Emery85/soil-moisture-sensor/docs/specs/ESP32_Solar_Sensor_TechSpec_v1.1.docx

TECHNICAL SPECIFICATION

ESP32 Solar-Powered Soil Moisture Sensor Node

Document Version 1.1 — 15 May 2026

Document Status | Released — For Build
Project Type | Personal Hobby / Non-commercial
Microcontroller | ESP32 (existing)
Firmware Framework | Arduino + PlatformIO
Data Destination | Discord webhook via HTTP POST
Author | Project Owner
Related Docs | Project Charter v0.1, BOM v1.0, Decision Log

Personal Project Documentation • Not for Distribution

# 1. Purpose and Scope

This Technical Specification defines the hardware wiring, component integration, development environment, firmware architecture, and calibration procedure for the ESP32 Solar-Powered Soil Moisture Sensor Node. It serves as the primary reference for physical assembly and software development, bridging the Bill of Materials (BOM v1.0) and the Wiring / Assembly Guide (D-6).

All design decisions referenced herein are recorded in the Decision Log. Open items OI-1 through OI-5 are closed; no blocking items remain.

# 2. System Overview

The sensor node consists of five functional subsystems:

Subsystem | Function | Key Components
Power | Solar harvest, battery charge management, regulated 3.3V supply | 6V 3W panel, TP4056 w/ protection, 18650 cell, LDO or MT3608
Sensing | Capacitive soil moisture measurement via ADC | Capacitive v1.2 module, ESP32 GPIO34 (ADC1_CH6)
Processing | Sample, sleep, wake, publish | ESP32-WROOM-32 or equivalent
Communication | Wi-Fi HTTP POST to Discord webhook on threshold breach | ESP32 Wi-Fi, HTTPClient library, ArduinoJson library
Enclosure | Weatherproof outdoor housing | IP65 junction box or PETG/ASA 3D print

The node operates on a 12-hour deep-sleep / wake / sample / publish cycle. Power consumption at this interval is effectively negligible relative to the solar harvest capacity confirmed in the power budget analysis.

# 3. Component Specifications

## 3.1 Microcontroller — ESP32

Parameter | Value
Module | ESP32-WROOM-32 (30-pin DevKit or equivalent breakout)
Core | Xtensa dual-core LX6, 240 MHz
Flash | 4 MB minimum
Wi-Fi | 802.11 b/g/n 2.4 GHz
Supply voltage | 3.3V regulated (DO NOT supply 5V to 3V3 pin)
Deep sleep current | ~10 µA (RTC timer wake only, peripherals off)
Active/Tx peak | ~240 mA (short burst during Wi-Fi transmit / HTTP POST)
ADC pins used | GPIO34 (ADC1_CH6) — input only, 3.3V max

WARNING: Never power the ESP32 3V3 pin from a 5V source. Use the VIN/USB pin only if the onboard LDO is present. When powering from the 18650 directly, route through a 3.3V LDO (e.g. AMS1117-3.3) or the TP4056 output rail if regulated.

## 3.2 Soil Moisture Sensor — Capacitive v1.2

Parameter | Value
Type | Capacitive (not resistive — no electrolysis corrosion)
Supply voltage | 3.3V – 5V (power from ESP32 3V3 or switched GPIO for power gating)
Output | Analog voltage, 0–3.0V typical range
Dry reading (air) | ~2900–3200 ADC counts (12-bit, 0–4095)
Wet reading (saturated) | ~1200–1500 ADC counts
Current draw | ~5 mA when active
Interface | Single analog wire to GPIO34
Conformal coat | REQUIRED on PCB traces before deployment (nail polish or acrylic spray acceptable)

NOTE: Calibrate wet and dry ADC counts on your specific unit before setting alert thresholds. Values vary between clone batches. See Section 8 (Calibration Procedure).

## 3.3 Charging Circuit — TP4056 with Protection Board

Parameter | Value
IC | TP4056 CC/CV Li-Ion charger + DW01A protection + FS8205 MOSFET
Module variant required | Two-chip module WITH protection board (NOT bare TP4056 alone)
Input voltage | 4.5V – 6V (verify your kit board includes a Schottky diode on the solar input — most do; see Section 3.3 notes)
Charge current | 1A default (R_prog = 1.2 kΩ) — adequate for 3400 mAh cell
Charge termination | CC/CV, terminates at 4.2V
Protection features | Over-charge, over-discharge (cutoff ~2.4V), over-current, short
Output (B+ / B-) | Direct cell voltage (3.6V–4.2V) — regulate before feeding ESP32
Standby current | <1 mA

NOTE: Most TP4056 kit/breakout boards sold for solar use already include a Schottky diode (or equivalent MOSFET-based reverse-blocking circuit) on the solar input. Inspect your board before adding an external diode — duplicating it wastes voltage and heat. If the board schematic or silkscreen shows a diode symbol on the IN+ trace, you are covered. If it only has a micro-USB/USB-C input and bare pads for solar, add a 1N5819 externally.

## 3.4 Power Regulation

Options for converting 18650 output (3.6V–4.2V) to 3.3V:

Option | Pros | Cons | Recommended
AMS1117-3.3 LDO | Simple, cheap (~$0.10) | Linear dropout; wastes voltage headroom near 3.6V | Acceptable for this load
HT7333 LDO | Lower dropout (100mV), low quiescent current (~4 µA) | Slightly more expensive | Preferred if available
ESP32 DevKit onboard LDO | Already present on most DevKits (AMS1117) | Powers via VIN/USB 5V input — needs MT3608 boost upstream | Use if boosting 18650 to 5V

NOTE: If powering the ESP32 DevKit via its USB/VIN pin, you need a MT3608 boost converter (18650 3.6–4.2V → 5V). If powering from 3V3 pin directly, use HT7333 or AMS1117-3.3.

## 3.5 Solar Panel

Parameter | Value
Rated power | 3W (6V, 500mA Isc)
Dimensions (typical) | 145 × 145 mm (varies by supplier)
Voc (open circuit) | ~7.2V — within TP4056 input range; Schottky drop reduces this ~0.3–0.5V
Connection | Connect to solar input pads on TP4056 board; verify board includes reverse-blocking diode (see Section 3.3 notes)

## 3.6 Battery

Parameter | Value
Cell type | 18650 Li-Ion
Capacity | 3400 mAh (Samsung 35E or equivalent)
Nominal voltage | 3.6V
Max charge voltage | 4.2V
Min discharge voltage | 3.0V (TP4056 protection cuts at ~2.4V)
Autonomy (no sun) | >2000 days at 12-hour sample interval (theoretical)

# 4. Pin Mapping and Wiring Assignments

## 4.1 ESP32 GPIO Assignments

GPIO | Function | Connected To | Direction | Notes
GPIO34 | Moisture ADC input | Sensor AOUT pin | Input | Input-only GPIO; 3.3V max; no internal pull-up
GPIO4 (optional) | Sensor power gate | Sensor VCC via MOSFET | Output | Pull HIGH to power sensor; pull LOW to cut power between readings (optional optimization)
3V3 | Sensor VCC (direct) | Sensor VCC if not gating | Power out | Max 200mA combined from 3V3 rail
GND | Common ground | Sensor GND, TP4056 GND, panel GND | Power | All grounds must be common
EN / RST | Wake from deep sleep | Not used (timer wake only) | Input | RTC timer handles wake; EN pulled high internally
VIN or USB | ESP32 power in (if using onboard LDO) | MT3608 5V output or USB power bank | Power in | Only if using DevKit onboard LDO path

## 4.2 Wiring Topology Diagram (Text)

The following describes the signal and power flow from panel to data:

Solar Panel (+) ──> TP4056 Solar IN+ (board includes reverse-blocking diode)

Solar Panel (-) ──────────────────────> TP4056 IN-

TP4056 B+ ──> 18650 (+) / TP4056 B- ──> 18650 (-)

TP4056 OUT+ ──> [HT7333 or AMS1117-3.3] IN ──> ESP32 3V3

OR

TP4056 OUT+ ──> [MT3608 Boost] IN ──> ESP32 VIN (5V)

ESP32 3V3 ──> Sensor VCC

ESP32 GND ──> Sensor GND

Sensor AOUT ──> ESP32 GPIO34

ESP32 Wi-Fi ~~(wireless)~~> Discord Webhook (HTTP POST on threshold breach)

NOTE: Draw or photograph your actual wiring before first power-on and retain it in the project file. Discrepancies between this spec and your build should be documented in the Decision Log.

## 4.3 Decoupling Capacitor — DevKit Considerations

ESP32 DevKit boards include onboard decoupling capacitors near the LDO regulator, which handle the majority of Wi-Fi transmit spikes under normal USB-powered conditions. For this project, power arrives via the TP4056 output through an LDO — a slightly less regulated path than USB.

In practice, brownout resets are uncommon on DevKits with a properly spec'd LDO and short wiring. The best first approach is to build without an external capacitor, run test T-05 (the deep-sleep/wake/publish cycle test in Section 10), and monitor Serial output for brownout reset messages. If resets occur, add a 470 µF electrolytic capacitor across the 3V3 and GND pins as close to the ESP32 module as possible — this is the proven fix. Keep the leads short; the capacitor is ineffective if mounted far from the chip.

# 5. Development Environment

## 5.1 Toolchain

Tool | Version | Purpose | Install / Source
PlatformIO IDE | Latest | Project management, build, flash, serial monitor | VS Code extension: platformio.platformio-ide
Arduino Framework (ESP32) | Arduino-esp32 ≥ 2.0 | HAL and Arduino API for ESP32 | Managed by PlatformIO automatically
HTTPClient | Built-in (Arduino-esp32) | HTTP POST to Discord webhook | Included with Arduino-esp32 framework — no separate install needed
ArduinoJson | ≥ 6.x | Build JSON payload for Discord message | PlatformIO library: bblanchon/ArduinoJson
Git | Any | Version control for firmware source | git-scm.com or OS package manager

## 5.2 PlatformIO Project Structure

my-soil-sensor/

platformio.ini ; board config, dependencies

src/

main.cpp ; application entry point

include/

config.h ; Wi-Fi creds, Discord webhook URL, thresholds (gitignored)

data/ ; SPIFFS/LittleFS assets if used

.gitignore ; exclude config.h, .pio/

## 5.3 platformio.ini (Baseline)

[env:esp32dev]

platform = espressif32

board = esp32dev

framework = arduino

monitor_speed = 115200

lib_deps =

bblanchon/ArduinoJson @ ^6

## 5.4 config.h (Template — gitignore this file)

#pragma once

// Wi-Fi

const char* WIFI_SSID = "your_ssid";

const char* WIFI_PASSWORD = "your_password";

// Discord

const char* DISCORD_WEBHOOK = "https://discord.com/api/webhooks/YOUR_ID/YOUR_TOKEN";

// Thresholds (ADC counts, 0-4095)

const int DRY_THRESHOLD = 2400; // calibrate per Section 8

WARNING: Never commit config.h to a public repository. It contains Wi-Fi credentials. Add it to .gitignore before the first commit.

# 6. Firmware Architecture

## 6.1 Execution Flow

The firmware follows a linear boot-to-sleep pattern. There is no persistent event loop. Each wake cycle is a complete, independent execution:

Step | Action | Key API / Notes
1 | Power on / wake from deep sleep | ESP.restart reason: ESP_SLEEP_WAKEUP_TIMER
2 | Configure ADC (12-bit, GPIO34) | analogSetAttenuation(ADC_11db) for 0–3.3V range
3 | Read sensor (optional: average 5 samples) | analogRead(34)
4 | Convert ADC to moisture percentage | Map dry_count→0%, wet_count→100%
5 | Connect to Wi-Fi (with timeout) | WiFi.begin() — timeout after 10s; log failure and sleep
6 | Build Discord JSON payload | ArduinoJson: {"content": "Soil moisture low: 28%"}
7 | HTTP POST to Discord webhook (conditional on threshold breach) | HTTPClient: POST to DISCORD_WEBHOOK URL; check HTTP 204 response
8 | Disconnect Wi-Fi | WiFi.disconnect(true); WiFi.mode(WIFI_OFF)
9 | Enter deep sleep (12 hours) | esp_sleep_enable_timer_wakeup(12ULL * 3600 * 1000000)
10 | esp_deep_sleep_start() | All peripherals off; RTC timer fires after 12h

## 6.2 Discord Notification Strategy

The device connects to Wi-Fi on every wake cycle (to keep the connection logic simple and avoid state management across deep sleep). However, it only POSTs to the Discord webhook when the moisture reading crosses below the alert threshold — not on every reading. This avoids notification spam at 2 readings/day.

Discord webhook POST format (JSON body):

POST https://discord.com/api/webhooks/YOUR_ID/YOUR_TOKEN

Content-Type: application/json

{ "content": "⚠️ Garden soil moisture is LOW: 28%\nRaw ADC: 2541\nCheck and water if needed." }

The webhook URL is obtained from Discord server settings: Server Settings > Integrations > Webhooks > New Webhook. The URL is sensitive — treat it like a password and do not commit it to a public repo (it is in the gitignored config.h).

Optional: use a Discord embed for richer formatting by posting a full embed object instead of a plain content string. Not required for v1.

NOTE: Discord webhooks return HTTP 204 No Content on success. Check for this in the HTTPClient response code to confirm delivery.

## 6.3 Deep Sleep Duration

The configured interval is 12 hours. To change the interval, modify the constant in main.cpp:

#define SLEEP_INTERVAL_US (12ULL * 3600ULL * 1000000ULL) // 12 hours

// For testing: use 30ULL * 1000000ULL (30 seconds) during bench validation

## 6.4 Error Handling

Condition | Behavior
Wi-Fi connect timeout (>10s) | Log error to Serial; skip HTTP POST; proceed to deep sleep
Discord webhook HTTP error (non-204) | Log response code to Serial; skip retry in v1; proceed to deep sleep
ADC read out of range | Clamp value to 0–100%; flag in payload: "status": "adc_warn"
Low battery (optional) | If voltage divider fitted on A0: publish battery_mv; no shutdown logic in v1

# 7. Discord Webhook Integration

## 7.1 Setting Up the Webhook

- Open the Discord server where notifications will be received
- Go to Server Settings > Integrations > Webhooks > New Webhook
- Name it (e.g. "Garden Sensor"), assign it to a dedicated channel (e.g. #garden-alerts)
- Click Copy Webhook URL — this is the URL that goes into config.h as DISCORD_WEBHOOK
- Test the webhook manually: use curl or a tool like Postman to POST a test message before flashing firmware

curl -X POST -H "Content-Type: application/json" \

-d '{"content": "Test from soil sensor"}' \

https://discord.com/api/webhooks/YOUR_ID/YOUR_TOKEN

Expected response: HTTP 204 No Content (empty body). Any 4xx response indicates an invalid or deleted webhook URL.

## 7.2 Mobile Notifications

Discord mobile app delivers push notifications for messages in channels you follow. To ensure alerts reach your phone:

- Enable notifications for the #garden-alerts channel in the Discord mobile app
- In channel settings, set notification override to "All Messages" so every webhook post triggers a push
- Discord push notifications typically arrive within a few seconds of the POST

## 7.3 Alert Logic

The firmware only POSTs when moisture falls below DRY_THRESHOLD. To avoid repeated alerts every 12 hours while the soil remains dry, consider one of these approaches in v1 firmware:

- Simple: alert on every reading below threshold (acceptable at 2 readings/day — low spam risk)
- Better: store a "last alert sent" flag in RTC memory (survives deep sleep); only alert once per dry event until moisture recovers above threshold

NOTE: RTC memory (rtc_data_attr variables) persists across deep sleep but is lost on full power cycle. Adequate for this use case.

# 8. Calibration Procedure

The capacitive v1.2 sensor output varies between individual units. Calibration must be performed before setting thresholds in config.h.

Step | Action | Record As
1 | Connect sensor to ESP32; load test sketch that prints analogRead(34) to Serial every 2 seconds | —
2 | Hold sensor in open air (completely dry) for 60 seconds; note stable ADC count | DRY_COUNT
3 | Submerge sensor electrode in water up to the max-fill line (do not submerge PCB); note stable ADC count | WET_COUNT
4 | Update DRY_THRESHOLD in config.h and the map() call: map(raw, WET_COUNT, DRY_COUNT, 100, 0) | —
5 | Verify: sensor in dry soil should read 0–20%; sensor in well-watered soil should read 60–100% | —
6 | Record calibration values in Decision Log | DRY_COUNT, WET_COUNT, date, unit ID

NOTE: ADC counts decrease as moisture increases (wetter soil = lower voltage output). The map() call reverses the range so that 100% = wettest.

# 9. Enclosure and Deployment

## 9.1 Enclosure Requirements

Requirement | Detail
IP rating | IP65 minimum (dust-tight, water jet resistant)
Material | IP65 junction box (ABS/polycarbonate) or PETG/ASA 3D print
Panel mount | Solar panel exterior; cable gland for wiring entry
Cable glands | IP68-rated; tighten after routing all wires; orient downward
Sensor probe routing | Probe exits through cable gland into soil; PCB remains inside enclosure
Conformal coat | Apply to sensor PCB traces before sealing; allow 24h cure time

## 9.2 Solar Panel Placement

- Mount panel at an angle (15–45°) facing south (northern hemisphere) for maximum daily exposure
- Avoid shade from trees, structures, or the enclosure itself in morning/afternoon hours
- Verify Wi-Fi signal strength at the planned install location before final mounting

# 10. Pre-Deployment Test Plan

The following tests must pass before outdoor deployment. Record results and any deviations in the Decision Log.

Test ID | Test Description | Pass Criteria
T-01 | Bench power — ESP32 on regulated 3.3V bench supply | Boots without brownout; Serial output visible
T-02 | Sensor ADC read — dry and wet calibration | DRY_COUNT and WET_COUNT recorded; values stable ±50 counts
T-03 | Wi-Fi connect | Connects to SSID within 10 seconds
T-04 | Discord webhook POST | HTTP 204 received; message appears in Discord channel on phone
T-05 | Deep sleep / wake cycle (30s interval) | Device wakes, reads, publishes, and sleeps repeatably for 10 cycles
T-06 | Full system — battery + TP4056 + LDO | System powers from 18650; no resets; Vout 3.3V ±0.1V
T-07 | Solar charging | TP4056 CHRG LED on in sunlight; STBY LED when full
T-08 | Enclosure seal test | Simulate rain (garden hose, 1 minute); no moisture inside
T-09 | 48-hour soak test | Device publishes correct readings every 12h for 4 cycles without intervention
T-10 | Discord alert trigger | Insert sensor in dry medium; Discord notification appears on phone within one publish cycle

# 11. Known Risks and Mitigations

Risk | Likelihood | Impact | Mitigation
Sensor corrosion in wet soil | Medium | Medium | Conformal coat before deployment; inspect quarterly; budget for replacement
Wi-Fi signal loss at garden location | Medium | High | Test signal at install location (T-03); consider ESP32 with external antenna if marginal
Brownout during Wi-Fi Tx | Low | Medium | DevKit has onboard decoupling; build without external cap first; add 470 µF at 3V3/GND if T-05 shows reset events (see Section 4.3)
Enclosure water ingress | Low | High | IP65 box; cable glands torqued; T-08 seal test required before deployment
TP4056 without protection board | Low | Critical | Verify two-chip module on arrival; mark protection chip with paint pen
ADC nonlinearity near 3.3V rail | Low | Low | Average 5 samples; discard outliers; stay in 0.1V–3.1V sensor output range

# 12. Document Control

Version | Date | Author | Changes
1.0 | 2026-05-13 | Project Owner | Initial release. All OIs closed. Ready for assembly.
1.1 | 2026-05-15 | Project Owner | Data destination updated: MQTT/Home Assistant replaced with Discord webhook (DL-07). Schottky diode guidance revised to reflect kit board inclusion. Decoupling capacitor guidance revised to test-first approach for DevKit. Section 7 rewritten for Discord integration.

Related documents: Project Charter v0.1 | BOM v1.0 | Decision Log | Wiring / Assembly Guide (D-6, pending)

— End of Document —

ESP32 Solar Soil Sensor — Technical Specification Page

TECHNICAL SPECIFICATION v1.1 | 2026-05-15
