Emery85/soil-moisture-sensor/docs/bom/BOM_Procurement.xlsx

Sheet: BOM
BILL OF MATERIALS (BOM) — PROCUREMENT TEMPLATE
Project: |  |  | [Project Name] |  | Revision: |  | A |  | Date: |  |  |  | Prepared By:
Item # | Vendor | Part Number | Manufacturer | Manufacturer Part # | Description | Revision | Category | UOM | Qty Per Assembly | Total Qty Required | Unit Cost (USD) | Extended Cost (USD) | Lead Time (Days) | Notes / Supplier
1 | Amazon | B08N1DD5WJ | Otdorpatio | 788405512983 | Electrical Junction Box Power Enclosure (7.87” x 4.72” x 2.95”) | A | Enclosures / Hardware |  | 1.00 | 1.00 | $9.99 | $9.99 | 2
2 | Amazon | B0FH6LH8WQ | Tnyvm | TYA250 | 2 IP68 Breather Screw Air Vent, M12x1.5 Presure Reducing valve, lighting breather plug for moisture and pressure control venting screw for outdoor electrical enclosures | A | Enclosures / Hardware |  | 1.00 | 1.00 | $2.94 | $2.94 | 2
3 | Amazon | B0FL22G77N | Meccanixity | mea25061ee000420 | 6V 3W 500mA mini solar panels, Small polycrystalline solar cell panel with 2 cable for DIY electric toy materials kits charger, 145mm x 145mm | A | Power & Energy |  | 1.00 | 1.00 | $13.29 | $13.29 | 20
4 | Amazon | B0FH22F8SB | 1DFAUL | 612715112000 | 100ml Conformal Coating for Electronics, Silicone Comformal coating insulating sealant, waterproof, dust & moisture resistant, for reliable electronic components protection | A | Coatings & Protection |  | 1.00 | 1.00 | $12.89 | $12.89 | 2
5 | Amazon | B082F7X8WS | HiLetgo | HiLetgo | 2pc CN3065 Mni Solar lipo Charger Board Lithium Battery charge chip micro usb diy outdoor application kit charging board module | A | Power & Energy | Set | 1.00 | 1.00 | $6.49 | $6.49 | 2
6 | Amazon | B0BJV7SK5D | DIANN | 687117701701 | 10pcs 18650 Battery Holder single 1x 3.7V 18650 Battery Holder 18650 Battery Holder with Wires | A | Power & Energy | Set | 1.00 | 1.00 | $5.99 | $5.99 | 2
7 | Amazon | B0CY8HM7HR | Vbeijll | US-VB-GZJ01 | Silica Gel Packets, Rechargeable Moisture absorbers for food storage, electronics, 3d filament & safes | A | Enclosures / Hardware | Set | 1.00 | 1.00 | $9.95 | $9.95 | 2
8 | Amazon | B01MSZW5HQ | uxcell | a16101800ux0286 | 10pcs M12 waterproof IP68 Nylon Cable Gland Joint adjustable locknut for 3mm-6.5mm dia Cable wire | A | Enclosures / Hardware | Set | 1.00 | 1.00 | $5.79 | $5.79 | 2
9 | Amazon | B094J8XD83 | AITRIP | AITRIP | 10 pack Capacitive Soil Moisture sensor corrosion resistant for arduino moisture detection garden watering DIY electronic for arduinio and raspberry pi | A | Sensors | Set | 1.00 | 1.00 | $11.99 | $11.99 | 2
10 | Amazon | B0F297R23T | Ladinka | cg001 | 580 pcs M3 Black Nylon standoff kit with spacers, screws and nuts – motherboard PCB mounting standoffs and screws, threaded pillar spacers for circuit boards and computer building | A | PCB & Assembly | Set | 1.00 | 1.00 | $0.24 | $0.24 | 2
11 | Amazon | B08D5ZD528 | AITRIP | 15363 | Esp-wroom-32 esp 32 esp-32s development board 2.4ghz dual-mode wifi + bluetooth dual cores microntroller processor integrated with antenna rf amp filter ap sta compatible with arduino ide (3 pcs) | A | Electronic Components | Set | 1.00 | 1.00 | $5.60 | $5.60 | 2
12 | DigiKey | 4518-A03400ACT-ND | UMW (VA) | A03400A | MOSFET N-CH 30V 5.7A SOT23-3L | A | Electronic Components | EA | 1.00 | 1.00 | $0.12 | $0.12 | 10
13 | DigiKey | CF14JT100KCT-ND | Stackpole Electronics INC | CF14J100k | 100kohm resistor ¼ W 5% | A | Electronic Components | EA | 1.00 | 1.00 | $0.02 | $0.02 | 10
14 | DigiKey | CF14J330RCT-ND | Stackpole Electronics INC | CF14J330R | 300 ohm resistor ¼ W 5% | A | Electronic Components | EA | 1.00 | 1.00 | $0.02 | $0.02 | 10
15 | Adafruit | 1230 | Adafruit | 1230 | SMT Breakout PCB set for SOT-23, SOT-89, SOT-223 and TO252 | A | PCB & Assembly | Set | 1.00 | 1.00 | $4.95 | $4.95 | 10
16 | Amazon | Discontinued | MORNGC | Discontinued | 3.7V Lithium Ion Battery | A | Power & Energy | Set | 1.00 | 1.00 | $23.89 | $23.89 | 2
17 | Amazon | B072Z7Y19F | ELEGOO | EL-CP-021 | 32 pcs double sided pcb board protypte kit for DIY soldering with 5 sizes compatible with arduino kits | A | PCB & Assembly | Set | 1.00 | 1.00 | $9.99 | $9.99 | 2
18 | Amaazon | B089CQHRDT | Fermerry | 695510396080 | 22 AWG Stranded Wire Spool 10ft each 6 colors flexible 22 gauge silicone hook up wire kit electrical tinned copper wire | A | Electronic Components | Kit | 1.00 | 1.00 | $12.99 | $12.99 | 2
19 | Amazon | B0D7Q9HJLQ | ZSDFYLLK | ZSDFYLLK-2P-2.0 | 20 sets mini micro JST-PH 2.0mm 2 pin male connector with 10cm Silicone wire cables and female socket JST PH 2.0 connector kit | A | Electronic Components | Set | 1.00 | 1.00 | $6.99 | $6.99 | 2
20
21
22
23
24
25
26
27
28
29
30
31
32
33
34
35
36
37
38
39
40
41
42
43
44
45
46
47
48
49
50
TOTAL PROCUREMENT COST |  |  |  |  |  |  |  |  |  |  |  | $144.12

Sheet: Summary
PROCUREMENT SUMMARY DASHBOARD
Category | Part Count | Total Qty | Extended Cost (USD) | Avg Lead Time (Days) | % of Total Cost
Electronic Components
Mechanical Parts
Fasteners & Hardware
Cables & Connectors
Enclosures / Housings
Other
GRAND TOTAL |  |  | $0.00

Sheet: Lookups
REFERENCE TABLES
Categories | Unit of Measure (UOM) | Procurement Status
Electronic Components | EA | Not Started
Mechanical Parts | PCS | RFQ Sent
Fasteners & Hardware | SET | Quote Received
Cables & Connectors | KG | PO Issued
Enclosures / Housings | M | Ordered
PCB Assembly | LOT | Received
Other | BOX | On Hold
