Emery85/soil-moisture-sensor/firmware/soil_moisture_monitor_production/config_template.h

// config.h — CREDENTIALS FILE
// ============================================================
// DO NOT COMMIT THIS FILE TO GIT.
// Ensure config.h is listed in .gitignore.
// Copy config_template.h → config.h and fill in your values.
// ============================================================

#ifndef CONFIG_H
#define CONFIG_H

// WiFi credentials
#define WIFI_SSID       "YOUR_WIFI_SSID"
#define WIFI_PASSWORD   "YOUR_WIFI_PASSWORD"

// Discord Webhook URL
// Get from: Server Settings → Integrations → Webhooks → New Webhook
#define DISCORD_WEBHOOK_URL  "https://discord.com/api/webhooks/YOUR_ID/YOUR_TOKEN"

#endif // CONFIG_H
