Emery85/soil-moisture-sensor/(commit log)

2026-05-23 Initial commit: ESP32 solar soil moisture sensor firmware and docs
    [BOM_Procurement.xlsx]
2026-05-25 Add schematics, complete mosfet and sensor tests, update decision log
    - Decision log v0.3: DL-11 superseded (HW-736 failure), DL-13 (TP4056
    replacement), DL-14 (dual capacitor config) added and closed
    - mosfet_test: sketch and README completed; T-004 and T-005 PASS
    - capacitor_sensor_test: calibration complete (air=3225, water=1100);
    fix placeholder constants and stale file path references
    - Three schematics added: mosfet_test, capacitor_sensor_test, boot/wifi/discord
    - BOM updated to reflect TP4056 module replacing failed HW-736 boards
    [BOM_Procurement.xlsx]
2026-06-14 Complete production firmware, documentation, and project closeout
    - Add production firmware (soil_moisture_monitor_production/) with
    scheduling, MOSFET switching, NTP sync, and Discord webhook alerts
    - Add production firmware README covering hardware, calibration,
    schedule logic, configuration, and expected serial output
    - Remove old firmware/production/ path (renamed to above)
    - Add AO3400A MOSFET datasheet to docs/datasheets/
    - Add MIT license body to LICENSE
    - Update README: correct charging IC (TP4056), firmware path,
    schematics note, and repo structure
    - Update charter: close all 5 open items with decision log refs,
    mark all deliverables complete, update Section 8 to project out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
    [config_template.h, soil_moisture_monitor_production.ino]
